ACEVS4US/BMS_MCU/BMS_MCU.brd

## EAGLE design BMS_MCU.brd (2021-01-10)

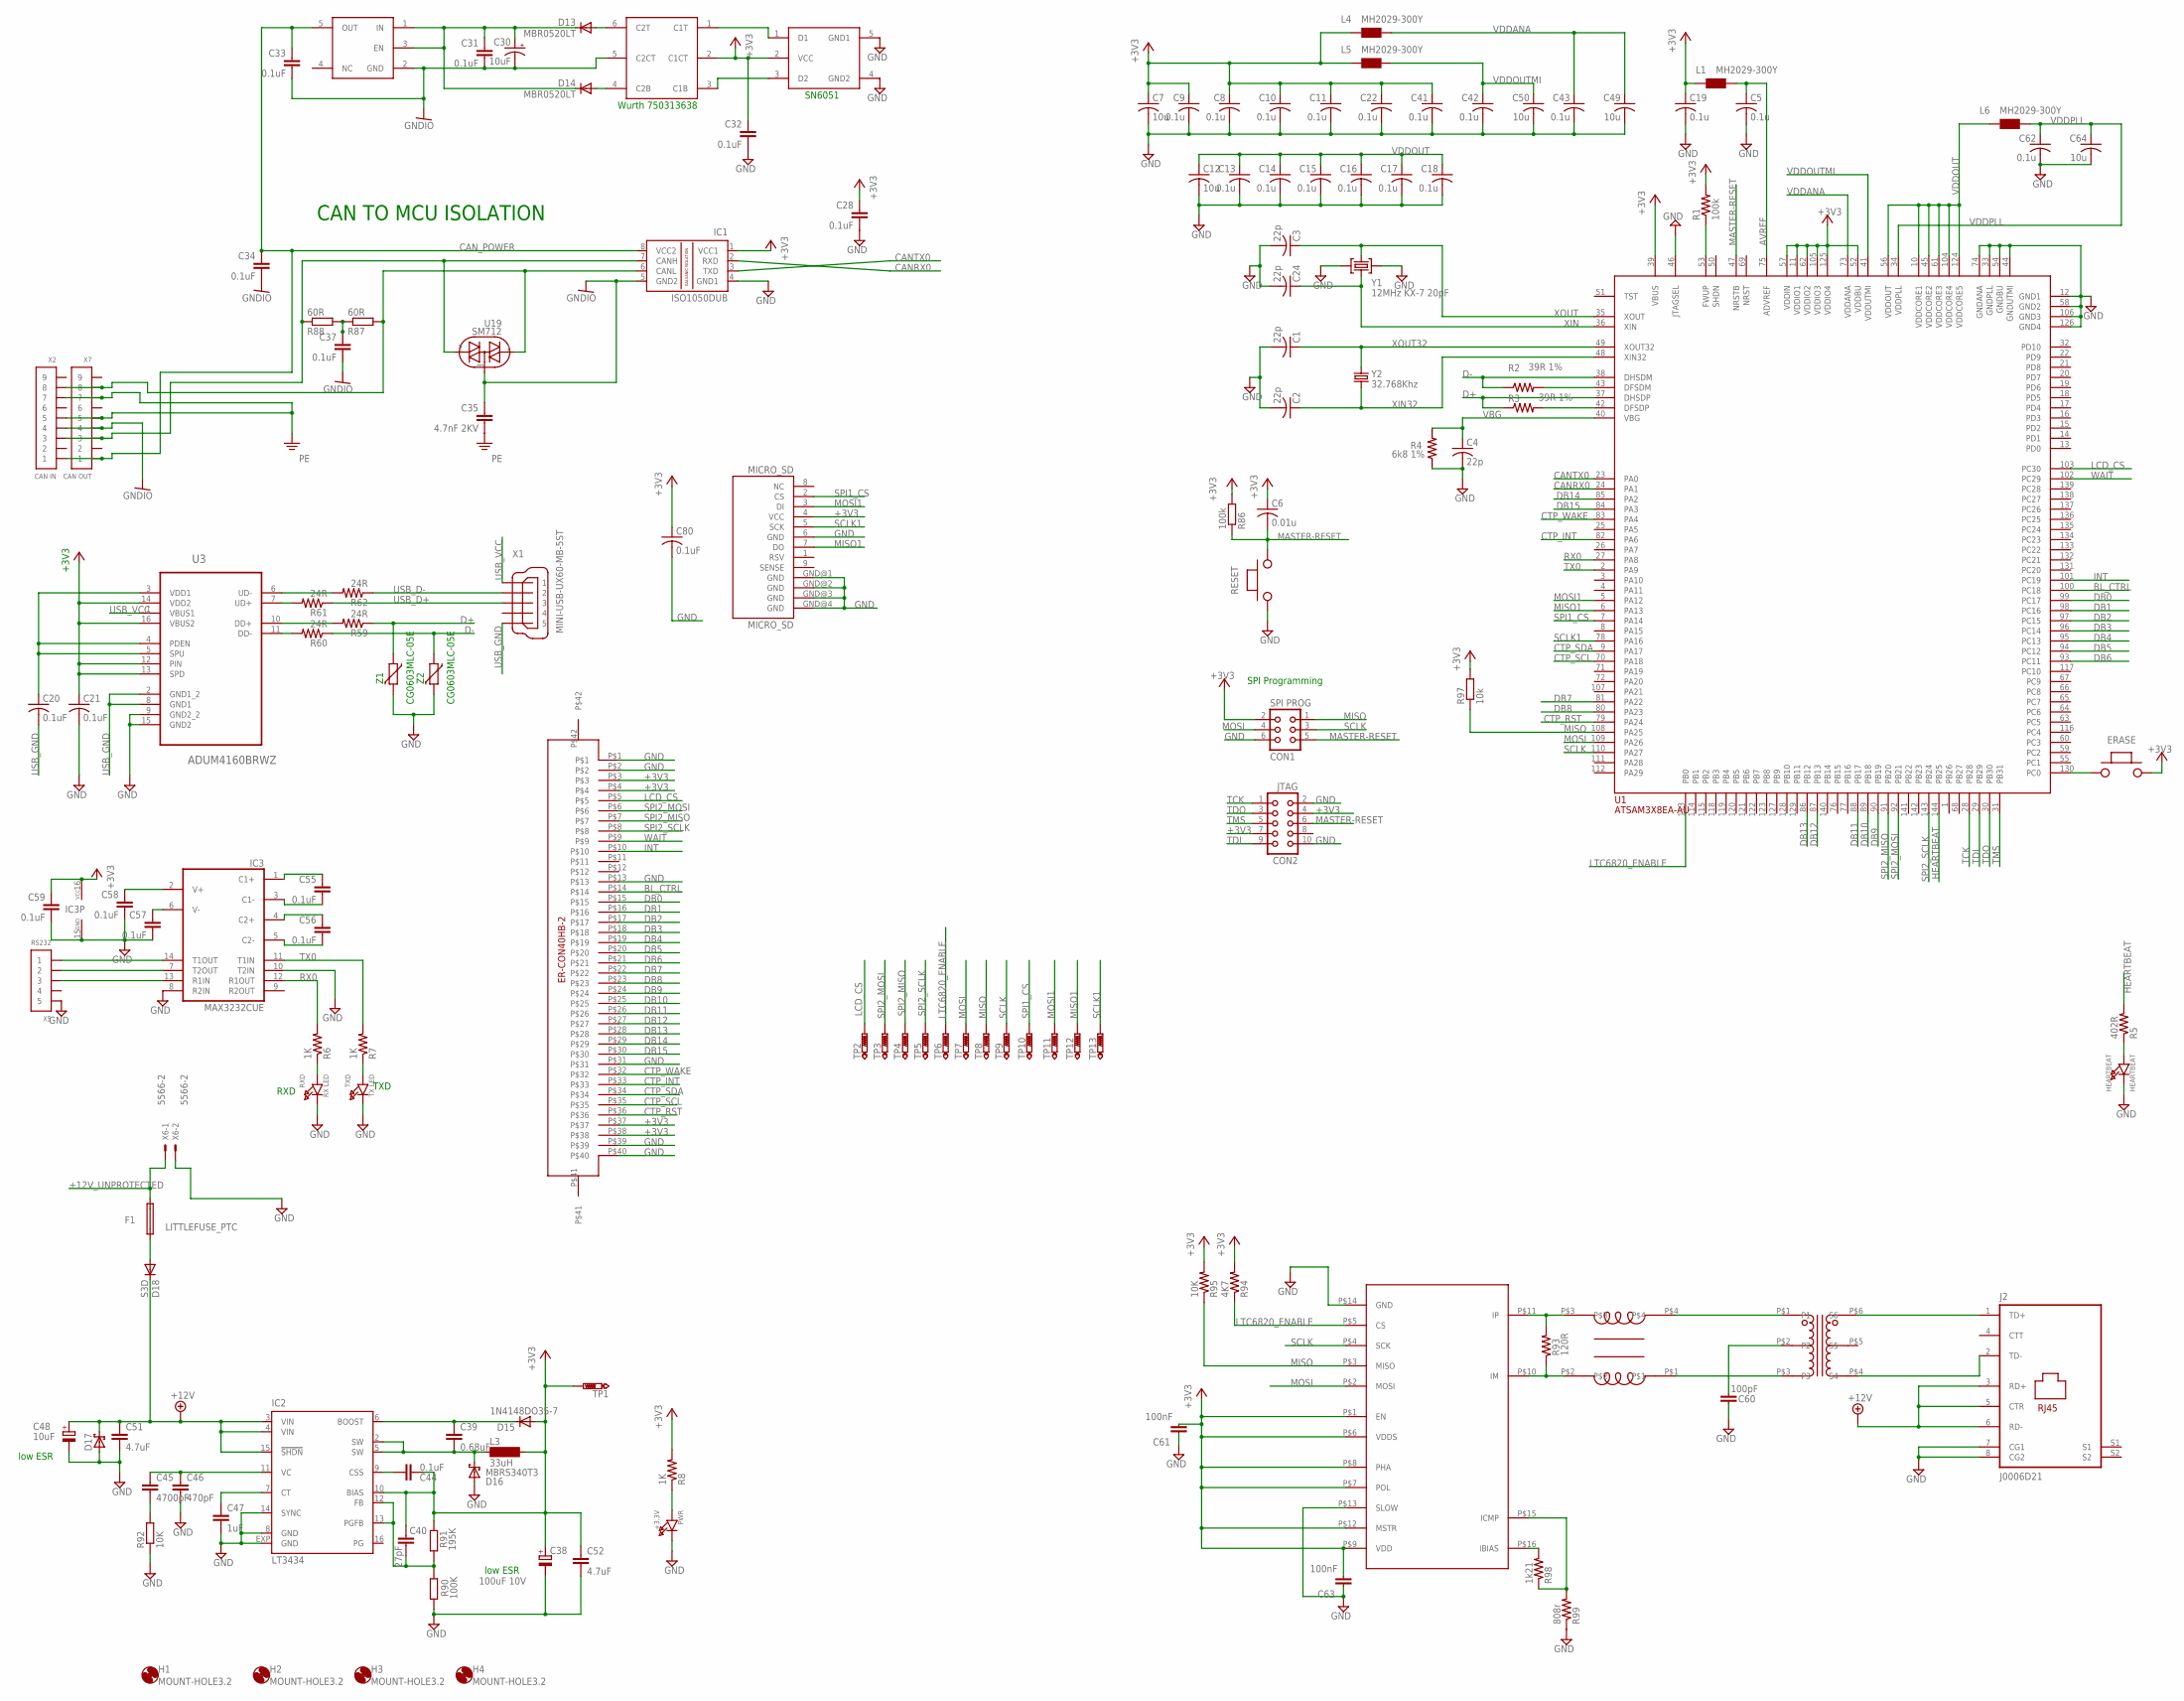
[picture p1: schematic BMS_MCU.sch]

Parts:
+3.3V: PWR; CHIPLED_0805
C1, C2, C4: 22p; C0805
C3, C24: 22p; C1206
C5, C8, C9, C10, C11, C13, C14, C15, C16, C17, C18, C19, C22, C41, C42, C43, C62: 0.1u; C0805
C6: 0.01u; C0805
C7, C12, C49, C50, C64: 10u; C0805
C20, C21, C28, C80: 0.1uF; C0805
C30, C48: 10uF; SMC_D
C31, C34, C44, C55, C56, C57, C58, C59: 0.1uF; C0603
C32, C33, C37: 0.1uF; C1206
C35: 4.7nF 2KV; C1206
C38: 100uF 10V; SMC_D
C39: 0.68uF; C0603
C40: 27pF; C0603
C45: 4700pF; C0603
C46: 470pF; C0603
C47: 1uF; C0603
C51, C52: 4.7uF; C1206
C60: 100pF; C1206@1
C61, C63: 100nF; C0603@1
CON1: SPI PROG; CON06
CON2: JTAG; CON10
D13, D14: MBR0520LT; SOD123
D15: 1N4148DO35-7; DO35-7
D16: MBRS340T3; SMC
D17: SCHOTTKY-DIODESMC; SMC
D18: S3D; SMC
ERASE: PUCHBUTTON
F1: LITTLEFUSE_PTC; 1812
H1, H2, H3, H4: MOUNT-HOLE3.2; 3,2
HEARTBEAT: HEARTBEAT; CHIPLED_0805
IC1: ISO1050DUB; DUB-R-PDSO-G8
IC2: LT3434; TSSOP16EXP
IC3: MAX3232CUE; TSSOP16
J2: J0006D21; J0-C/D/E
L1, L4, L5, L6: MH2029-300Y; 0805
L3: 33uH; MS85
MICRO_SD: MICRO_SD; MICROSD_PP
R1: 100k; R0805
R2, R3: 39R 1%; R0805
R4: 6k8 1%; R0805
R5: 402R; R0805
R6, R7, R8: 1K; R0805
R59, R60, R61, R62: 24R; R0805
R86: 100k; R0603
R87, R88: 60R; R0603
R90: 100K; R0603
R91: 195K; R0603
R92, R95: 10K; R0603
R93: 120R; R0603
R94: 4K7; R0603
R97: 10k; R0603
R98: 1k21; R0603
R99: 808r; R0603
RESET: PUCHBUTTON
RXD: RX LED; CHIPLED_0805
TP1, TP2, TP3, TP4, TP5, TP6, TP7, TP8, TP9, TP10, TP11, TP12, TP13: PTR1PAD1-13; P1-13
TXD: TX LED; CHIPLED_0805
U1: ATSAM3X8EA-AU; LQFP144
U2: LTC6820; MSOP16
U3: ADUM4160BRWZ; SOIC127P1032X265-16N
U16: SN6501; SOT23-DBV
U17: WURTHWURTH; TSOT23-6_DDC
U18: TPS76350; SOT23-DBV
U19: SM712; SOT23
U$1: DLW43SH510XK2; DLW43S
U$2: ER-CON40HB-2
U$4: T3001NL
X1: MINI-USB-UX60-MB-5ST; UX60-MB-5ST
X2: CAN IN; PB-53398-09
X5: RS232; CM-502386-05
X6: 5566-2
X7: CAN OUT; PB-53398-09
Y1: 12MHz KX-7 20pF; CRYSTAL-3.2-2.5
Y2: 32.768Khz; ARDUINO_WIFI_SHIELD_V018_TG_RESONATOR_EPSON_FC_145
Z1, Z2: CG0603MLC-05E; CT/CN0603

Connections:
+3V3: C6.1, C7.1, C8.1, C9.1, C10.1, C11.1, C19.1, C21.1, C22.1, C28.1, C32.1, C38.+, C40.1, C41.1, C44.2, C52.1, C59.1, C61.1, C63.1, C80.1, CON1.2, CON2.7, D15.A, ERASE.P$2, IC1.1 (VCC1), IC2.10 (BIAS), IC3.16 (VCC), L1.1, L3.2, L4.1, L5.1, MICRO_SD.4 (VCC), R1.2, R8.2, R86.2, R91.1, R94.2, R95.2, R97.2, TP1.TP, U1.11 (VDDIO1), U1.39 (VBUS), U1.52 (VDDBU), U1.57 (VDDIN), U1.62 (VDDIO2), U1.105 (VDDIO3), U1.125 (VDDIO4), U2.P$1 (EN), U2.P$6 (VDDS), U2.P$7 (POL), U2.P$8 (PHA), U2.P$9 (VDD), U2.P$12 (MSTR), U3.12 (PIN), U3.13 (SPD), U3.14 (VDD2), U3.16 (VBUS2), U16.2 (VCC), U17.2 (C1CT), U$2.P$3, U$2.P$4, U$2.P$37, U$2.P$38
+12V: C48.+, C51.1, D17.C, D18.C, IC2.3 (VIN), IC2.4 (VIN), IC2.15 (!SHDN), J2.3 (RD+), J2.5 (CTR), J2.6 (RD-)
+12V_UNPROTECTED: F1.P$2 (2), X6.1
AVREF: C5.1, L1.2, U1.75 (ADVREF)
BL_CTRL: U1.100 (PC18), U$2.P$14
CANRX0: IC1.2 (RXD), U1.24 (PA1)
CANTX0: IC1.3 (TXD), U1.23 (PA0)
CAN_POWER: C33.1, C34.1, IC1.8 (VCC2), U18.5 (OUT), X2.1, X7.1
CTP_INT: U1.82 (PA6), U$2.P$33
CTP_RST: U1.79 (PA24), U$2.P$36
CTP_SCL: U1.70 (PA18), U$2.P$35
CTP_SDA: U1.9 (PA17), U$2.P$34
CTP_WAKE: U1.83 (PA4), U$2.P$32
D+: R3.1, R59.1, U1.37 (DHSDP), Z1.1
D-: R2.1, R60.1, U1.38 (DHSDM), Z2.1
DB0: U1.99 (PC17), U$2.P$15
DB1: U1.98 (PC16), U$2.P$16
DB2: U1.97 (PC15), U$2.P$17
DB3: U1.96 (PC14), U$2.P$18
DB4: U1.95 (PC13), U$2.P$19
DB5: U1.94 (PC12), U$2.P$20
DB6: U1.93 (PC11), U$2.P$21
DB7: U1.81 (PA22), U$2.P$22
DB8: U1.80 (PA23), U$2.P$23
DB9: U1.90 (PB19), U$2.P$24
DB10: U1.89 (PB18), U$2.P$25
DB11: U1.88 (PB17), U$2.P$26
DB12: U1.87 (PB13), U$2.P$27
DB13: U1.86 (PB12), U$2.P$28
DB14: U1.85 (PA2), U$2.P$29
DB15: U1.84 (PA3), U$2.P$30
ERASE_S: ERASE.P$1, U1.130 (PC0)
GND: +3.3V.C, C1.2, C2.2, C3.2, C4.2, C5.2, C7.2, C8.2, C9.2, C10.2, C11.2, C12.2, C13.2, C14.2, C15.2, C16.2, C17.2, C18.2, C19.2, C21.2, C22.2, C24.2, C28.2, C32.2, C38.-, C41.2, C42.2, C43.2, C46.2, C47.2, C48.-, C49.2, C50.2, C51.2, C52.2, C57.2, C58.2, C59.2, C60.2, C61.2, C62.2, C63.2, C64.2, C80.2, CON1.6, CON2.2, CON2.10, D16.A, D17.A, HEARTBEAT.C, IC1.4 (GND1), IC2.8 (GND), IC2.14 (SYNC), IC2.EXP (GND), IC3.8 (R2IN), IC3.10 (T2IN), IC3.15 (GND), J2.7 (CG1), J2.8 (CG2), MICRO_SD.6 (GND), MICRO_SD.GND@1 (GND), MICRO_SD.GND@2 (GND), MICRO_SD.GND@3 (GND), MICRO_SD.GND@4 (GND), R4.1, R90.1, R92.1, R99.1, RESET.P$1, RXD.C, TXD.C, U1.12 (GND1), U1.33 (GNDPLL), U1.44 (GNDUTMI), U1.46 (JTAGSEL), U1.54 (GNDBU), U1.58 (GND2), U1.74 (GNDANA), U1.106 (GND3), U1.126 (GND4), U2.P$13 (SLOW), U2.P$14 (GND), U3.9 (GND2_2), U3.15 (GND2), U16.4 (GND2), U16.5 (GND1), U$2.P$1, U$2.P$2, U$2.P$13, U$2.P$31, U$2.P$39, U$2.P$40, X5.5, X6.2, Y1.2 (GND), Y1.4 (GND), Z1.2, Z2.2
GNDIO: C30.-, C31.2, C33.2, C34.2, C35.1, C37.2, IC1.5 (GND2), U17.5 (C2CT), U18.2 (GND), U19.3 (T2), X2.4, X7.4
HEARTBEAT: R5.2, U1.144 (PB25)
INT: U1.101 (PC19), U$2.P$10
LCD_CS: TP2.TP, U1.103 (PC30), U$2.P$5
LTC6820_ENABLE: R94.1, TP6.TP, U1.113 (PB0), U2.P$5 (CS)
MASTER-RESET: C6.2, CON1.5, CON2.6, R86.1, RESET.P$2, U1.47 (NRSTB)
MISO: CON1.1, R95.1, R97.1, TP8.TP, U1.108 (PA25), U2.P$3 (MISO)
MISO1: MICRO_SD.7 (DO), TP12.TP, U1.6 (PA13)
MOSI: CON1.4, TP7.TP, U1.109 (PA26), U2.P$2 (MOSI)
MOSI1: MICRO_SD.3 (DI), TP11.TP, U1.5 (PA12)
unnamed: U$1.P$4, U$4.P$1 (P1)
unnamed: U$1.P$1, U$4.P$3 (P3)
unnamed: +3.3V.A, R8.1
unnamed: J2.2 (TD-), U$4.P$4 (S4)
unnamed: J2.1 (TD+), U$4.P$6 (S6)
unnamed: HEARTBEAT.A, R5.1
unnamed: C20.1, U3.3 (VDD1), U3.4 (PDEN), U3.5 (SPU)
unnamed: U16.1 (D1), U17.1 (C1T)
unnamed: D13.A, U17.6 (C2T)
unnamed: R62.2, U3.6 (UD-)
unnamed: R61.2, U3.7 (UD+)
unnamed: R6.1, RXD.A
unnamed: R7.1, TXD.A
unnamed: C30.+, C31.1, D13.C, D14.C, U18.1 (IN), U18.3 (EN)
unnamed: D14.A, U17.4 (C2B)
unnamed: R59.2, U3.10 (DD+)
unnamed: R60.2, U3.11 (DD-)
unnamed: R93.2, U2.P$11 (IP), U$1.P$3
unnamed: R2.2, U1.43 (DFSDM)
unnamed: IC1.6 (CANL), R87.2, U19.1 (T1), X2.8, X7.8
unnamed: IC1.7 (CANH), R88.1, U19.2 (T3), X2.3, X7.3
unnamed: R3.2, U1.42 (DFSDP)
unnamed: R1.1, U1.53 (FWUP)
unnamed: C40.2, IC2.12 (FB), IC2.13 (PGFB), R90.2, R91.2
unnamed: C55.1, IC3.1 (C1+)
unnamed: C55.2, IC3.3 (C1-)
unnamed: C56.1, IC3.4 (C2+)
unnamed: R93.1, U2.P$10 (IM), U$1.P$2
unnamed: C60.1, U$4.P$2 (P2)
unnamed: C56.2, IC3.5 (C2-)
unnamed: U16.3 (D2), U17.3 (C1B)
unnamed: C57.1, IC3.6 (V-)
unnamed: C37.1, R87.1, R88.2
unnamed: C39.1, D15.C, IC2.6 (BOOST)
unnamed: C44.1, IC2.9 (CSS)
unnamed: C39.2, D16.C, IC2.2 (SW), IC2.5 (SW), L3.1
unnamed: C47.1, IC2.7 (CT)
unnamed: C45.1, C46.1, IC2.11 (VC)
unnamed: C45.2, R92.2
unnamed: D18.A, F1.P$1 (1)
unnamed: IC3.14 (T1OUT), X5.1
unnamed: IC3.7 (T2OUT), X5.2
unnamed: IC3.13 (R1IN), X5.3
unnamed: C58.1, IC3.2 (V+)
unnamed: R98.1, R99.2, U2.P$15 (ICMP)
unnamed: R98.2, U2.P$16 (IBIAS)
PE: C35.2, X2.5, X2.7, X7.5, X7.7
RX0: IC3.12 (R1OUT), R6.2, U1.27 (PA8)
SCLK: CON1.3, TP9.TP, U1.110 (PA27), U2.P$4 (SCK)
SCLK1: MICRO_SD.5 (SCK), TP13.TP, U1.78 (PA16)
SPI1_CS: MICRO_SD.2 (CS), TP10.TP, U1.7 (PA14)
SPI2_MISO: TP4.TP, U1.91 (PB20), U$2.P$7
SPI2_MOSI: TP3.TP, U1.92 (PB21), U$2.P$6
SPI2_SCLK: TP5.TP, U1.143 (PB24), U$2.P$8
TCK: CON2.1, U1.28 (PB28)
TDI: CON2.9, U1.29 (PB29)
TDO: CON2.3, U1.30 (PB30)
TMS: CON2.5, U1.31 (PB31)
TX0: IC3.11 (T1IN), R7.2, U1.2 (PA9)
USB_D+: R61.1, X1.3
USB_D-: R62.1, X1.2
USB_GND: C20.2, U3.2 (GND1_2), U3.8 (GND1), X1.5
USB_VCC: U3.1 (VBUS1), X1.1
VBG: C4.1, R4.2, U1.40 (VBG)
VDDANA: C43.1, C49.1, L4.2, U1.73 (VDDANA)
VDDOUT: C12.1, C13.1, C14.1, C15.1, C16.1, C17.1, C18.1, L6.1, U1.10 (VDDCORE1), U1.45 (VDDCORE2), U1.56 (VDDOUT), U1.61 (VDDCORE3), U1.104 (VDDCORE4), U1.124 (VDDCORE5)
VDDOUTMI: C42.1, C50.1, L5.2, U1.41 (VDDUTMI)
VDDPLL: C62.1, C64.1, L6.2, U1.34 (VDDPLL)
WAIT: U1.102 (PC29), U$2.P$9
XIN: C24.1, U1.36 (XIN), Y1.1 (C1)
XIN32: C2.1, U1.48 (XIN32), Y2.P$2 (2)
XOUT: C3.1, U1.35 (XOUT), Y1.3 (C2)
XOUT32: C1.1, U1.49 (XOUT32), Y2.P$1 (1)

Notes on the sheet:
SN6051
Wurth 750313638
CAN TO MCU ISOLATION
low ESR
RXD
TXD
SPI Programming

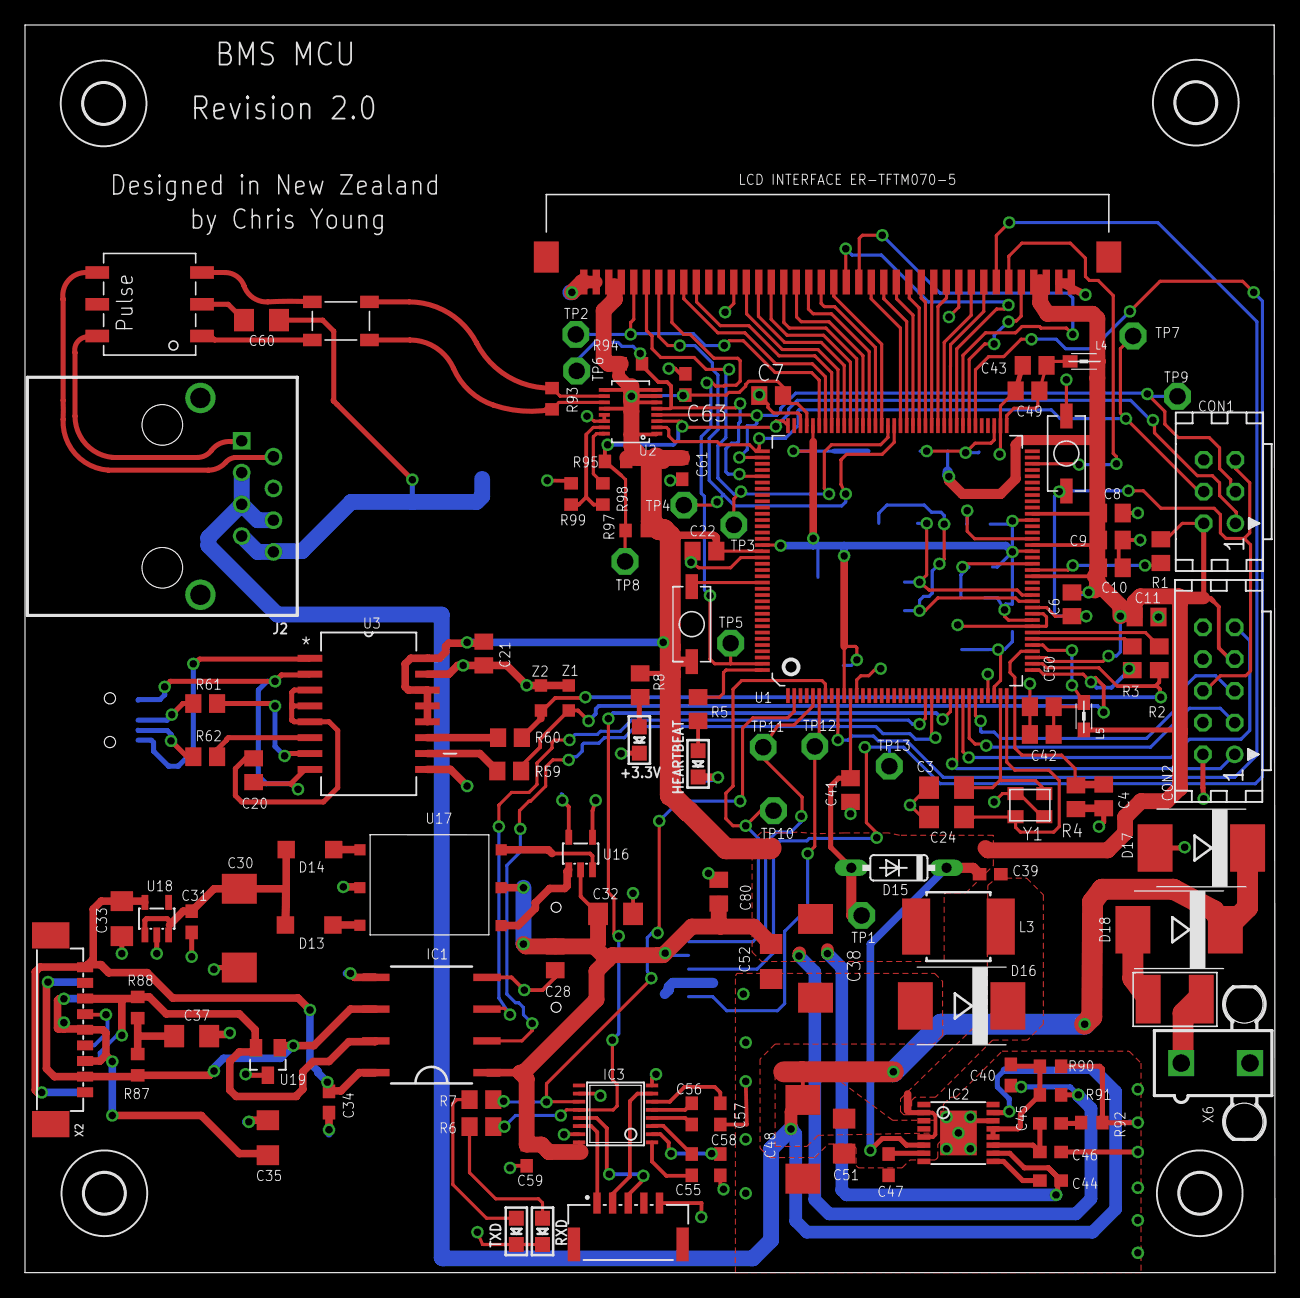
[picture p2: board BMS_MCU.brd from above]

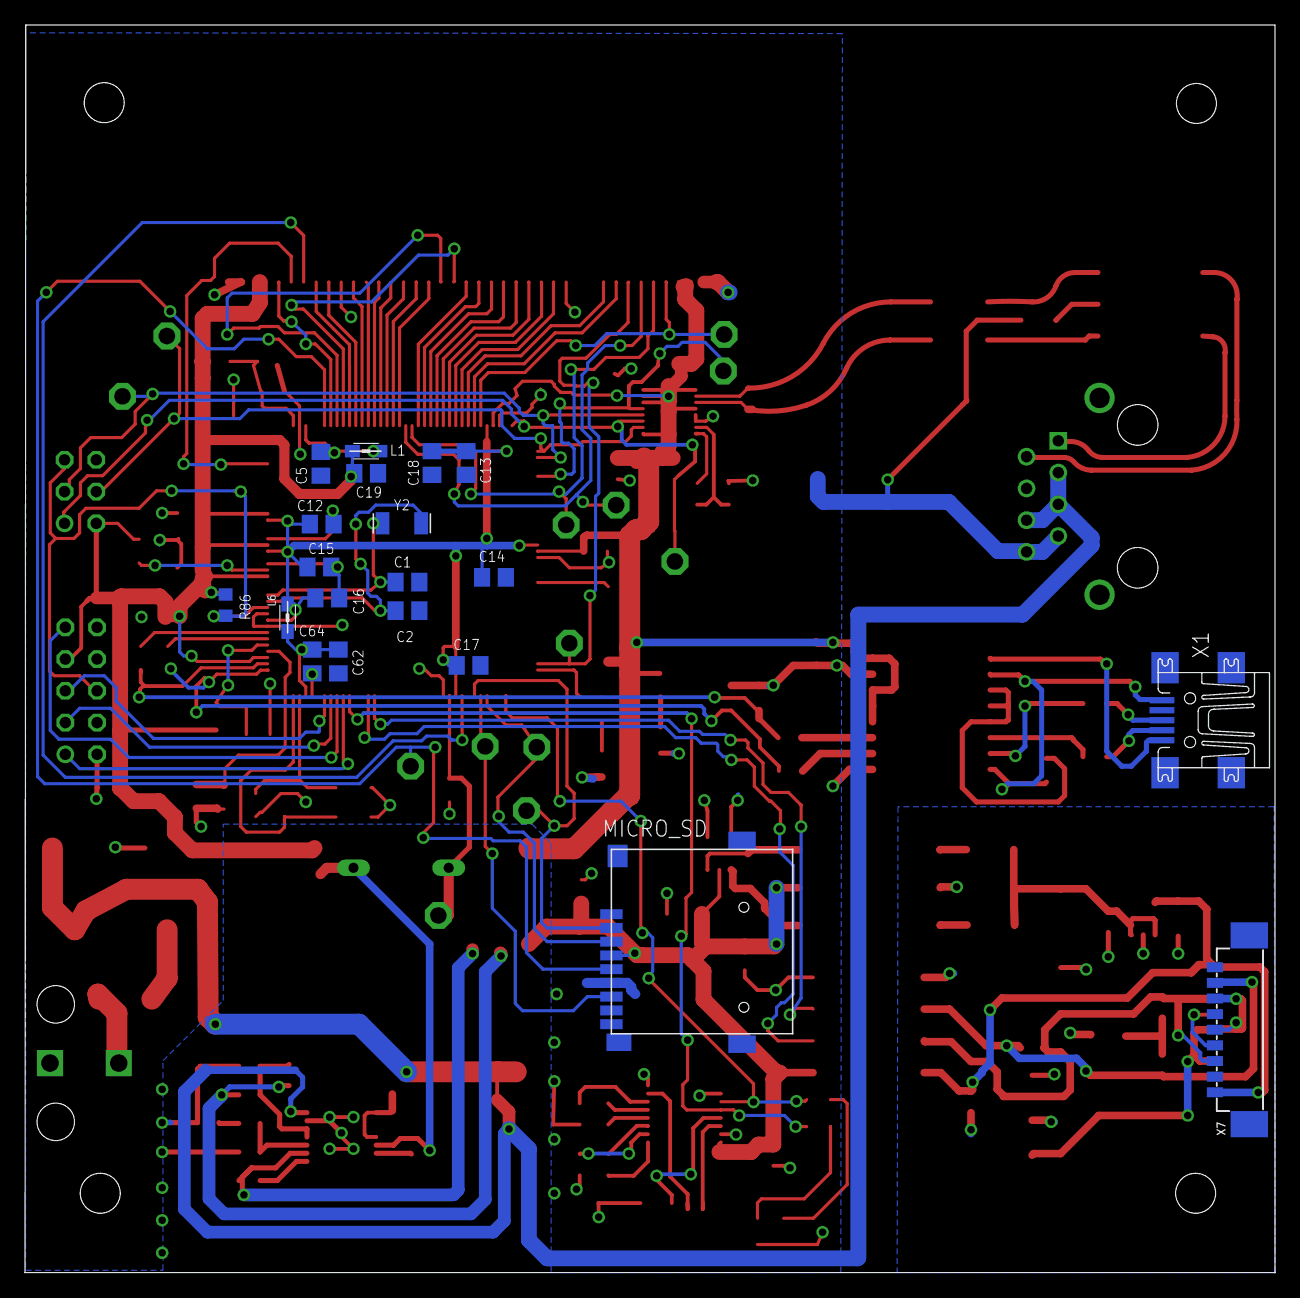
[picture p3: board BMS_MCU.brd from below]

Board: 2 copper layers, 100.0 x 99.8 mm, 142 parts (20 on the bottom side), 116 nets.
